mercur4148/MN82-ESP32-C3-RX-ESC/Hardware/Scope/HIGH gear/02. IDLE to FORWARD fast.png

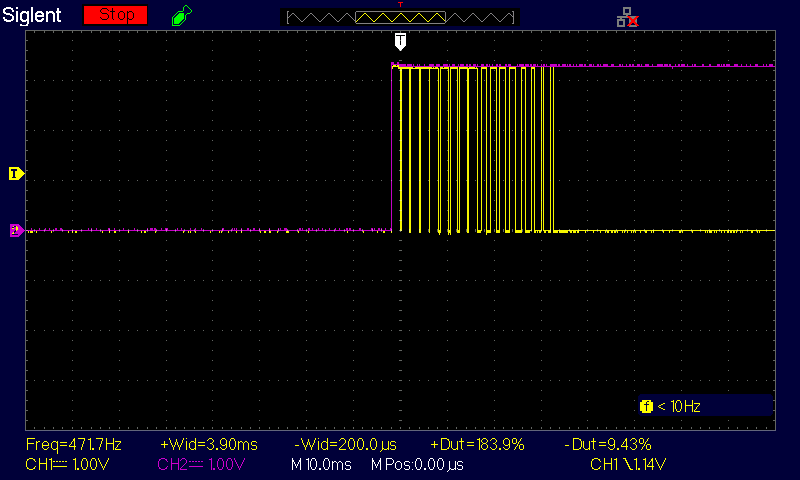
Hardware/Scope/HIGH gear/02. IDLE to FORWARD fast.png
