mercur4148/MN82-ESP32-C3-RX-ESC/Hardware/Scope/HIGH gear/04. FORWARD slow.png

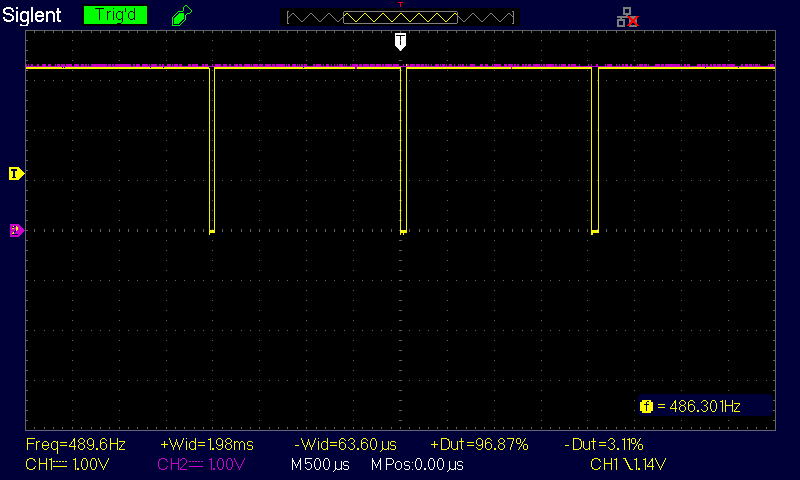
Hardware/Scope/HIGH gear/04. FORWARD slow.png
