mercur4148/MN82-ESP32-C3-RX-ESC/Hardware/Scope/HIGH gear/07.  REVERSE fast to IDLE.png

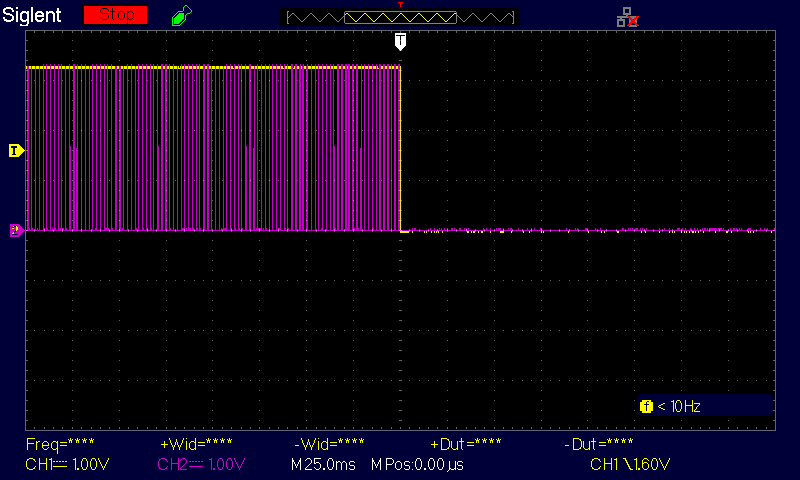
Hardware/Scope/HIGH gear/07. REVERSE fast to IDLE.png
