mercur4148/MN82-ESP32-C3-RX-ESC/Hardware/Scope/HIGH gear/10. Some driving.png

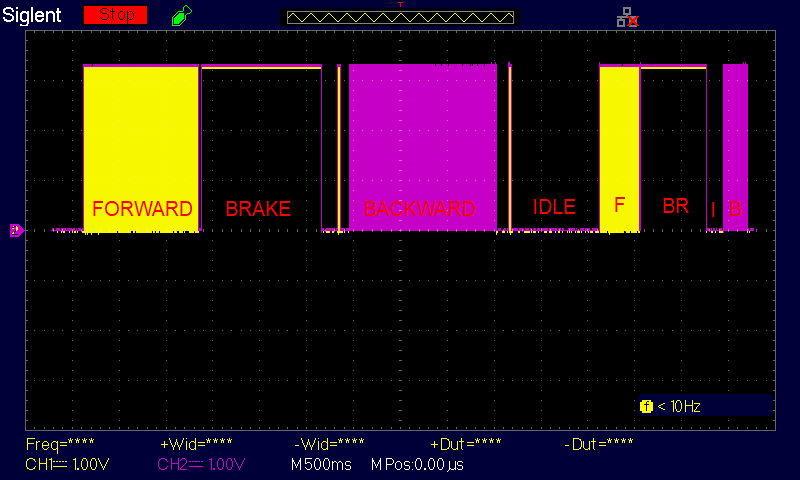
Hardware/Scope/HIGH gear/10. Some driving.png
