mercur4148/MN82-ESP32-C3-RX-ESC/Hardware/Scope/HIGH gear/11. BRAKES applied.png

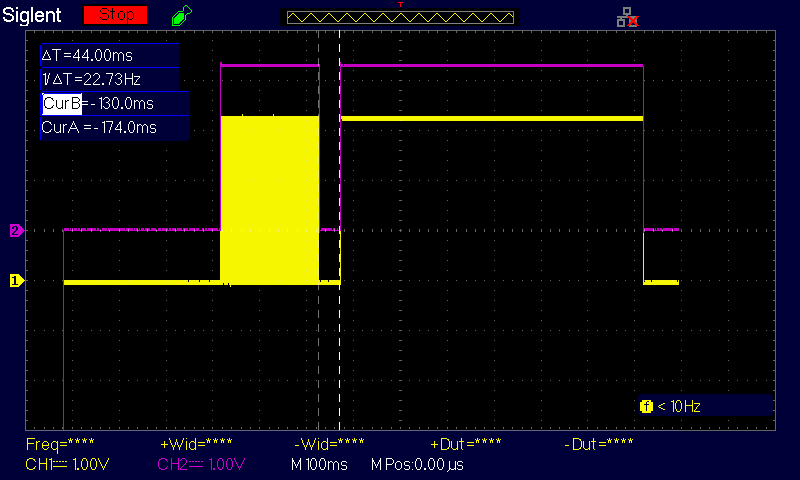
Hardware/Scope/HIGH gear/11. BRAKES applied.png
