mercur4148/MN82-ESP32-C3-RX-ESC/Hardware/Scope/LOW gear/01. IDLE to FORWARD.png

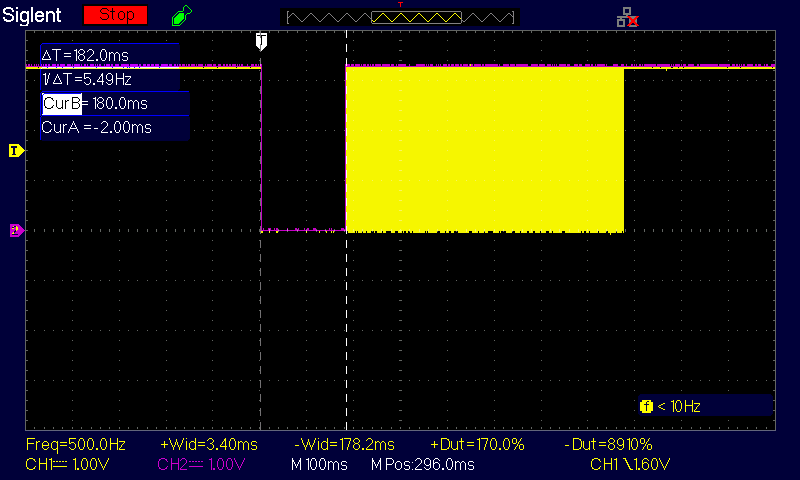
Hardware/Scope/LOW gear/01. IDLE to FORWARD.png
