mercur4148/MN82-ESP32-C3-RX-ESC/Hardware/Scope/LOW gear/02. IDLE to REVERSE.png

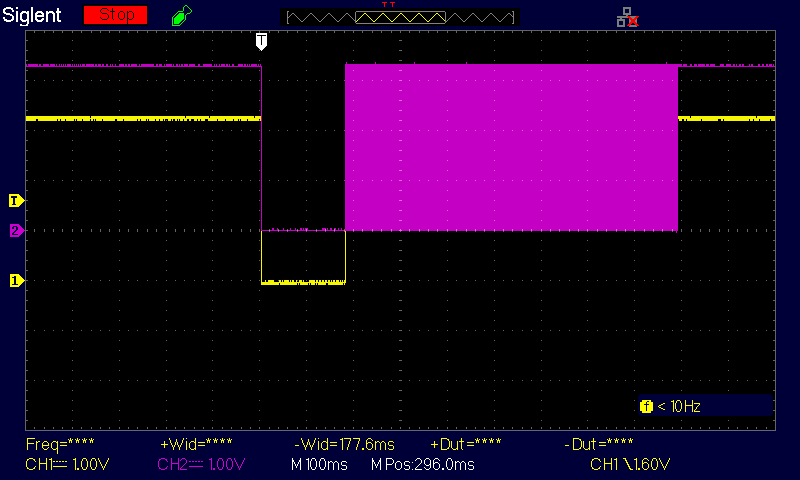
Hardware/Scope/LOW gear/02. IDLE to REVERSE.png
