mercur4148/MN82-ESP32-C3-RX-ESC/Hardware/Scope/LOW gear/04. FORWARD fast.png

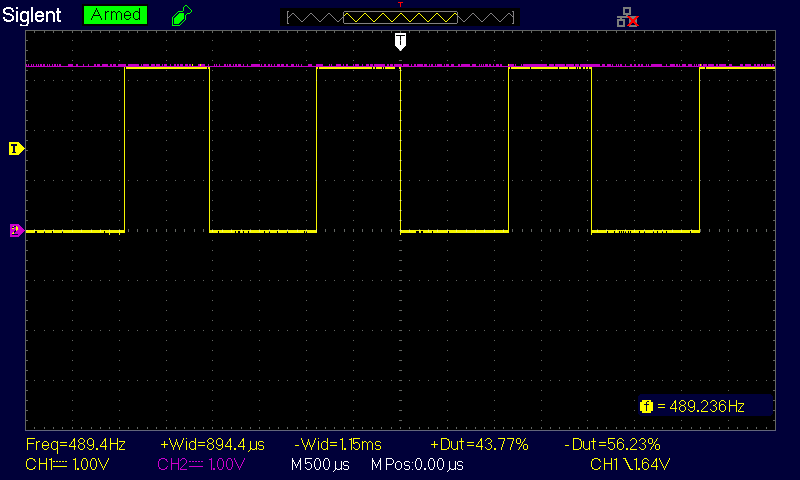
Hardware/Scope/LOW gear/04. FORWARD fast.png
