mercur4148/MN82-ESP32-C3-RX-ESC/Hardware/Bill of Materials-MN82 ESP32.xlsx

Number | Designator | Comment | Voltage Rating | Tolerance | Size | Quantity | Supplier
1 | A1 | ESP32-C3 SuperMini |  |  |  | 1 | https://arduino.ua/prod6618-mikroplata-esp32-c3-type-c-12-gpio
2 | C1, C6, C7, C8, C9, C11, C13 | 10uF | 16V | 10% | 0805 | 7 | https://www.kosmodrom.ua/smd-kondensator-1813/chip-keramika-0805-10mkf-x7r-16v-10-2.html
3 | C2 | 100nF | 50V | 10% | 0603 | 1 | https://www.kosmodrom.ua/smd-kondensator-1813/chip-keramika-0603-0-1mkf-x7r-50v-10.html
4 | C3, C4, C5 | 10uF | 50V | 10% | 1206 | 3 | https://www.kosmodrom.ua/smd-kondensator-1813/chip-keramika-1206-10mkf-x7r-50v-10-2.html
5 | C10 | 470uF | 10V | 20% | 6.3*11*2.5 | 1 | REUSE
6 | C12 | 220uF | 16V | 20% | 6.3*11*2.5 | 1 | REUSE
7 | L1 | 4.7uH |  | 20% | 2020 | 1 | https://www.kosmodrom.ua/drosel/drossel-smd0520-4-7-mkgn-2.html
8 | R1 | 120k |  | 5% | 0603 | 1 | REUSE
9 | R2 | 22k |  | 5% | 0603 | 1 | REUSE
10 | R3 | 10k |  | 5% | 0603 | 1 | https://www.kosmodrom.ua/smd-rezistor-2513/smd-rezistor-0603-10-kom-1-tochni.html
11 | R4, R12 | 1k |  | 5% | 0603 | 2 | REUSE
12 | R5 | 330 |  | 5% | 0603 | 1 | https://www.kosmodrom.ua/smd-rezistor-2513/smd-rezistor-0603-330-om-5.html
13 | R6, R7 | 33 |  | 5% | 0603 | 2 | REUSE
12 | R8 | 330 |  | 5% | 0603 | 1 | REUSE
14 | R9, R10 | 10 |  | 5% | 0603 | 2 | REUSE
15 | R11 | 47 |  | 5% | 0603 | 1 | https://www.kosmodrom.ua/smd-rezistor-2513/smd-rezistor-0603-47-om-5.html
16 | U1 | AP63205WU-7 |  |  | SOT23-6 | 1 | https://www.kosmodrom.ua/dc-dc-peretvoryuvach-integralniy/ap63205wu-7.html
17 | U2 | ASIC |  |  | SOIC-16 | 1 | REUSE
18 | U3 | SA8336 |  |  | DIP-8 | 1 | REUSE
19 | VD1, VD2 | BAT60 |  |  | SOD323 | 2 | https://www.kosmodrom.ua/diod-shottki-2/bat60jfilm.html
20 | VT1 | APM4953KC-TR |  |  | SOIC-8 | 1 | https://voron.ua/uk/catalog/034298--tranzistor_apm4953kc-tr_so8_so8
21 | VT2 | DTC114ECA |  |  | SOT23 | 1 | https://voron.ua/uk/catalog/029372--tranzistor_dtc114eca_cj_jiangsu_changjiang_electronics_technology_co_ltd_sot23_s
23 | XP1 | NXW-02 |  |  |  | 1 | https://www.kosmodrom.ua/roznimannya-signalni-nx-z-krokom-2-mm/nxw-02.html
24 | XP2 | NXW-03 |  |  |  | 1 | REUSE
23 | XP3, XP5, XP6 | NXW-02 |  |  |  | 3 | REUSE
25 | XP4 | NXW-06 |  |  |  | 1 | REUSE
26 | XP7 | PLS-3R-U1 |  |  |  | 1 | REUSE
27 | ZQ1 | ? |  |  | 3225 | 1 | REUSE
