mercur4148/MN82-ESP32-C3-RX-ESC/Hardware/Assembly Drawings.PDF

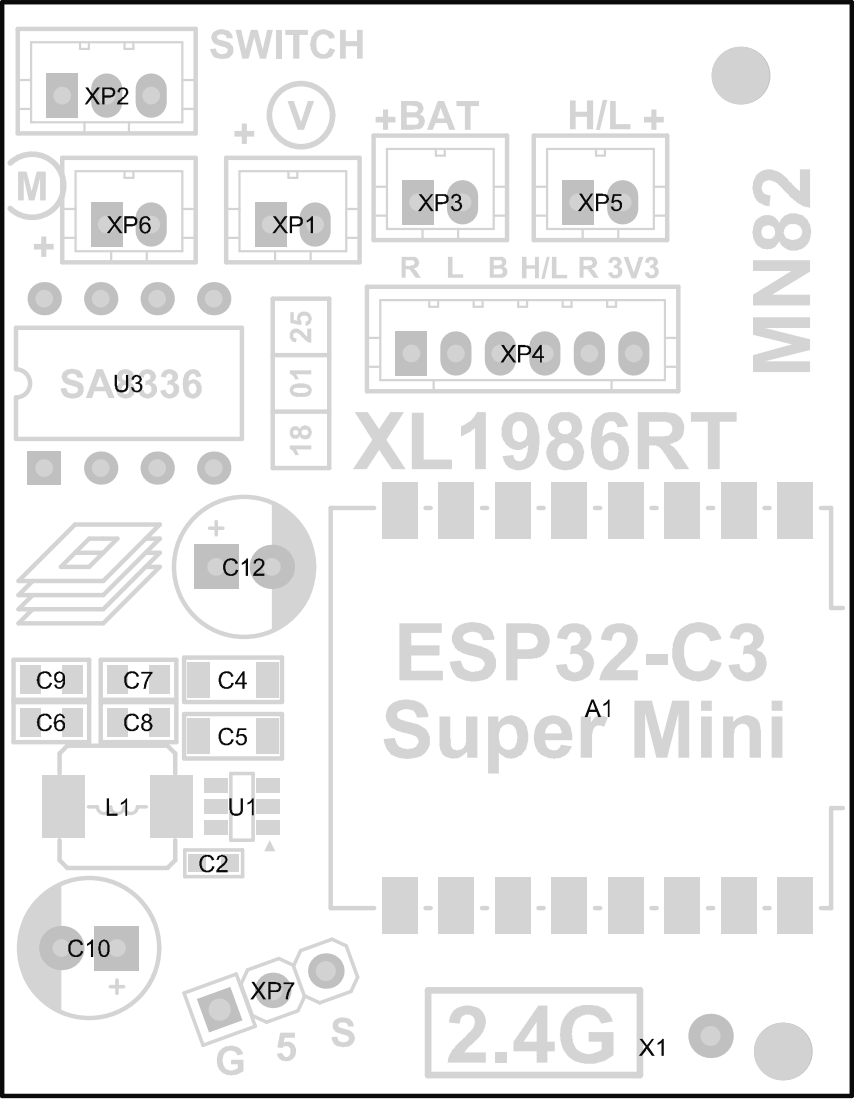
[picture p13: page 1]

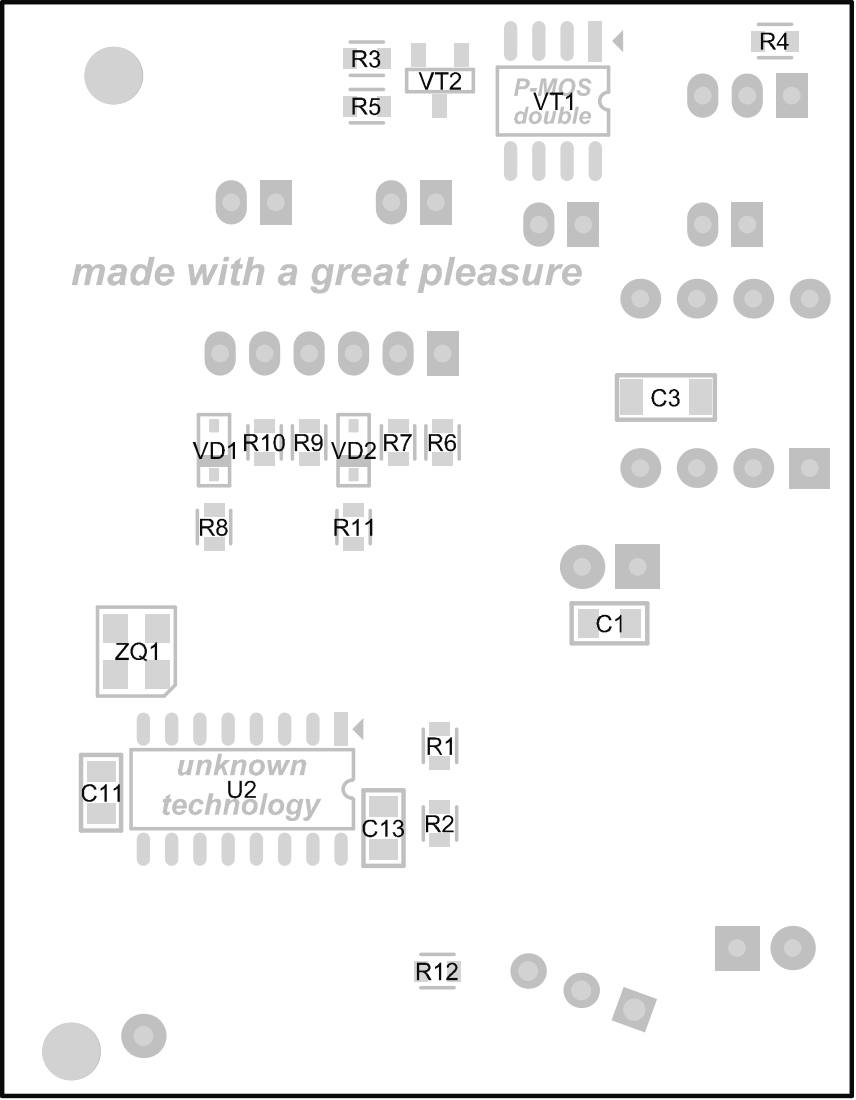
[picture p14: page 2]
