mercur4148/MN82-ESP32-C3-RX-ESC/Hardware/Schematic Prints.PDF

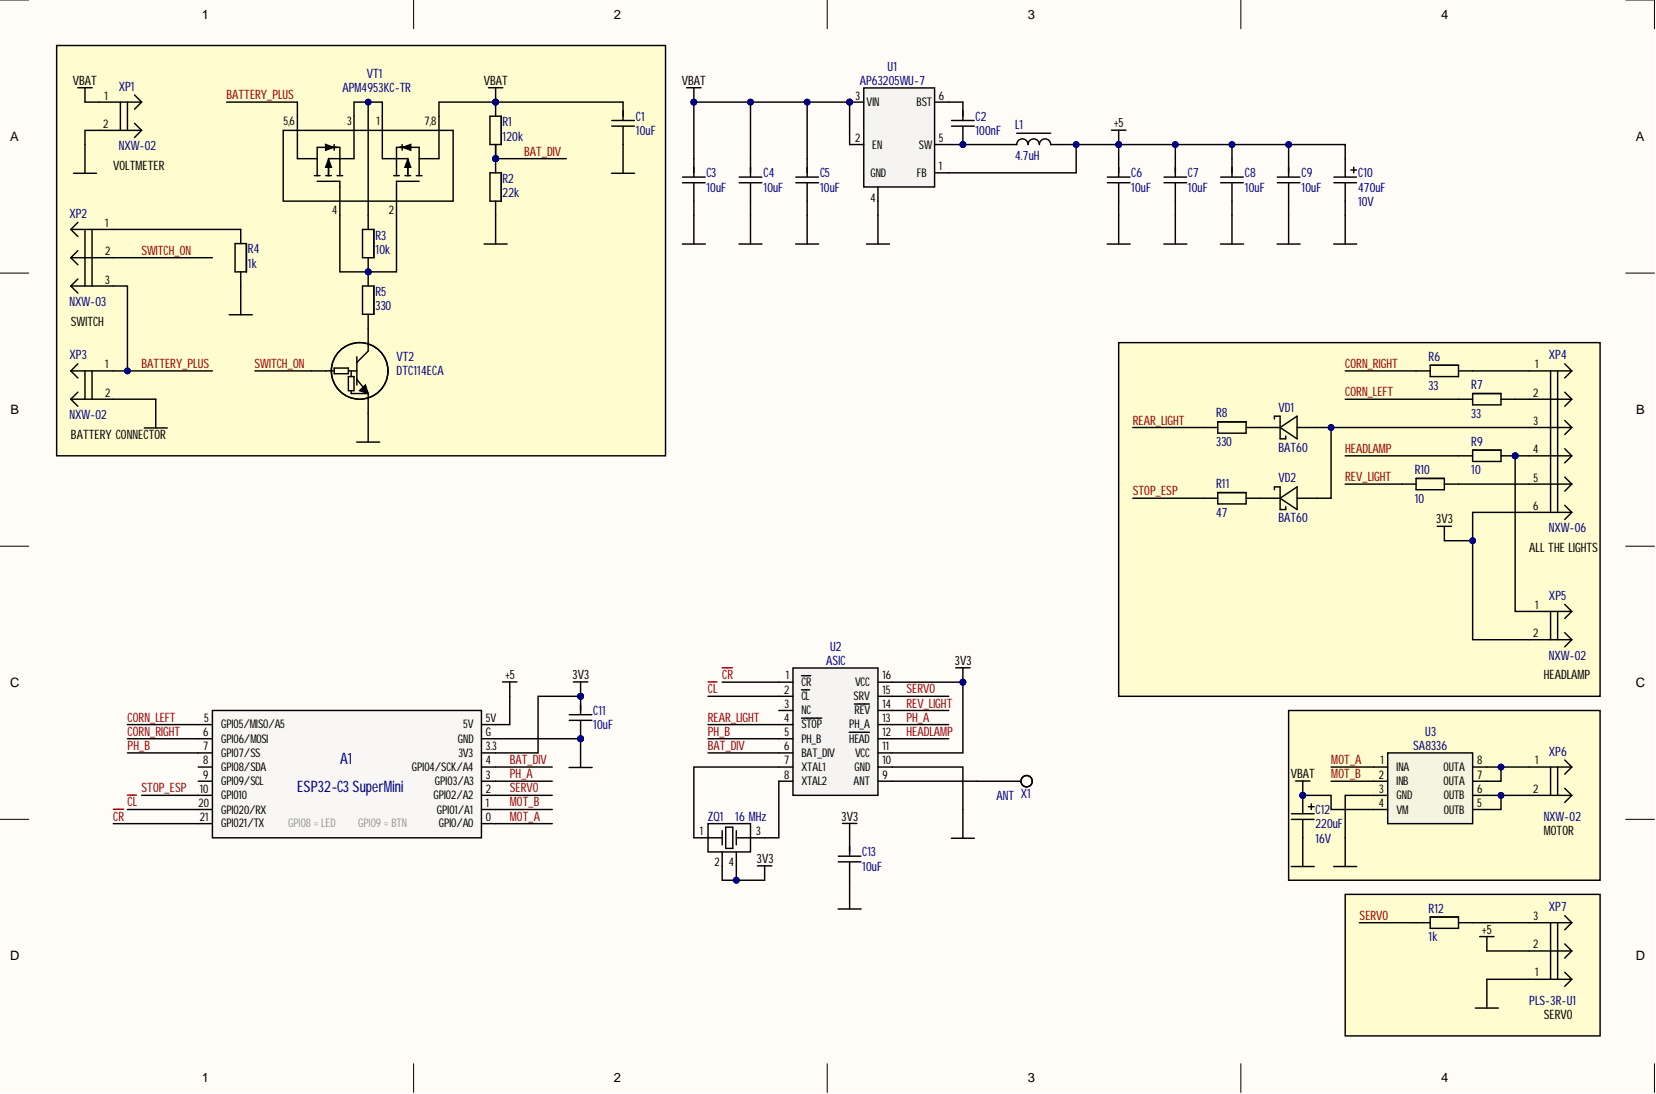
[picture p15: page 1]
