mercur4148/MN82-ESP32-C3-RX-ESC/(commit log)

2025-07-21 Changed battery meter and added percentage calculations
2025-07-21 WebSerial won't be lagging anymore
    [MN82_ESP32-C3.ino, debug_print.ino]
2025-07-31 Configassist now runs on 160 MHz
    [partitions.csv]
